f0x52/f0xparts/README.md

## USBCWrover
Datasheet: https://github.com/sebastius/USBCWrover
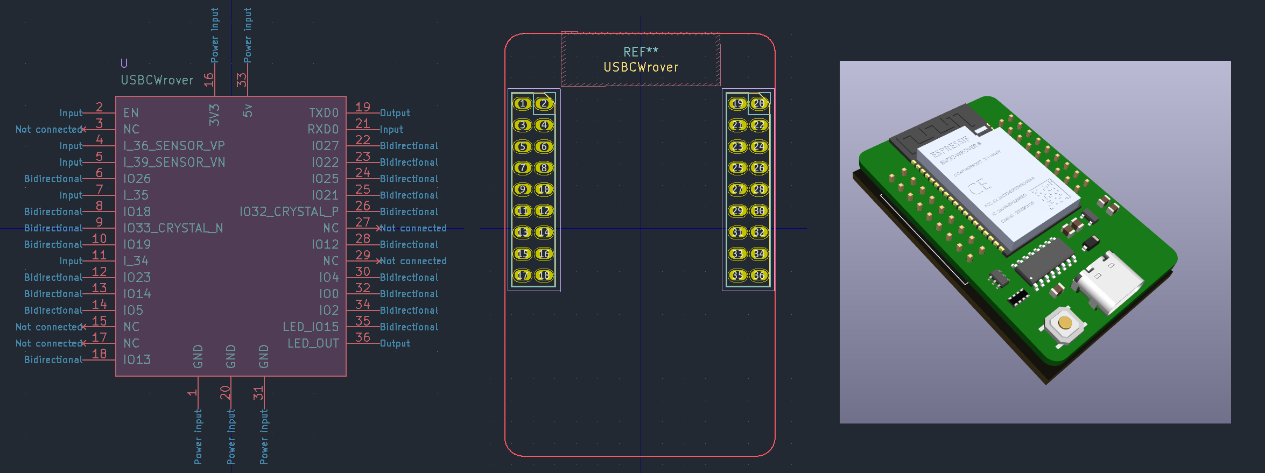
[picture p1: screenshots/USBCWrover.png]
USBC Wrover


## ESP32-WROVER-B
Datasheet: https://www.espressif.com/sites/default/files/documentation/esp32-wrover-b_datasheet_en.pdf

## USB Cereal
USB flashing + ESP32 reset/boatloader
Datasheet: https://git.pixie.town/f0x/usb-cereal

## License
GPL-3.0
