f0x52/f0xparts/3dmodels/oled_ssd1306.step

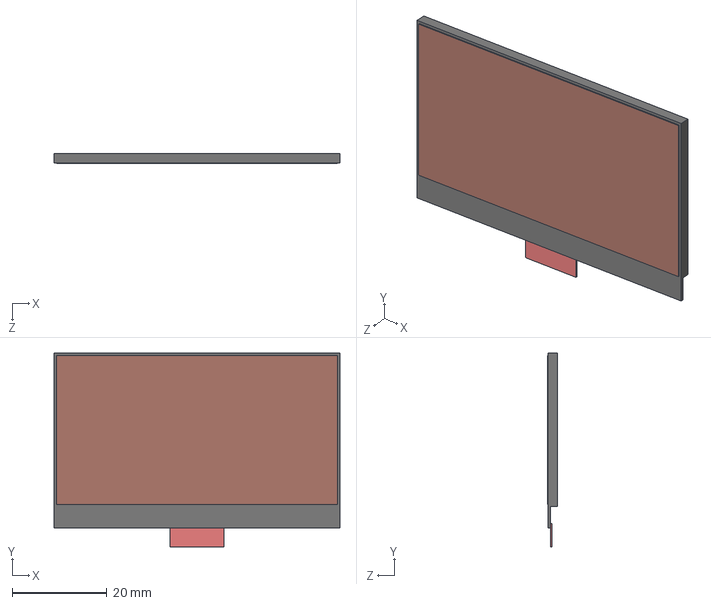
[picture p2: CAD file, 2020-11-14]
3dmodels/oled_ssd1306.step
60.5 x 41.0 x 2.20 mm
