f0x52/f0xparts/3dmodels/APA102 2020 LED.step

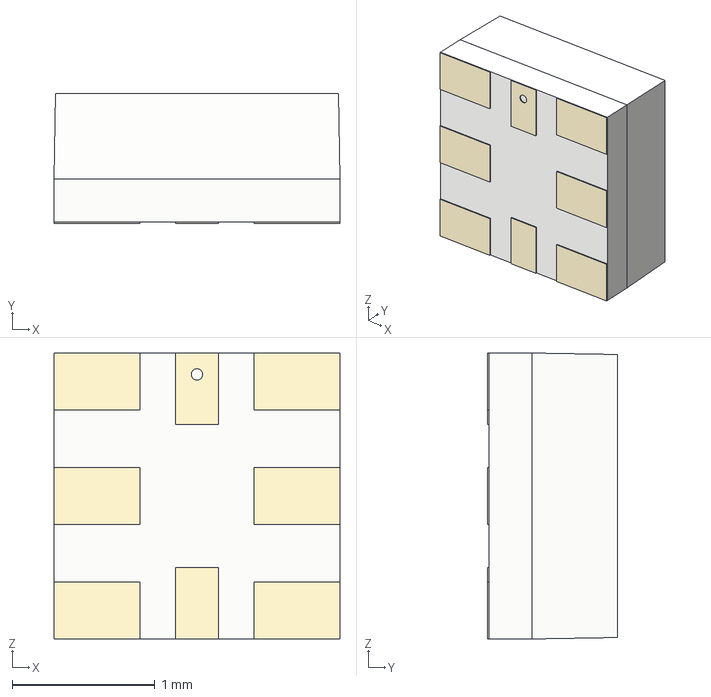
[picture p3: CAD file, 2020-11-07]
3dmodels/APA102 2020 LED.step
2.00 x 0.91 x 2.00 mm
