f0x52/f0xparts/(commit log)

2020-09-08 USBCWrover footprints and step model
2020-11-06 add ESP32-WROVER-B
2020-11-06 add USB-Cereal connector
2020-11-07 add SK9822-2020, SSD1306 0.96", E4SW and USB-Cereal
    [APA102 2020 LED.step, oled_ssd1306.step]
2020-11-09 add dual nmos, dual led, charging chips
2020-11-10 remove unusable ESP32-WROVER pins
2020-11-14 footprint update
    [oled_ssd1306.step]
2020-11-18 fix SK9822 footprints
2020-11-20 add f0xprint to switch footprint, update pattern
2020-12-05 USB-C power-only footprint
2020-12-05 add FS8205A, USB-C power-only symbols
